akohlsmith/thermador_hpcb36ns_fw/pcb_front.png

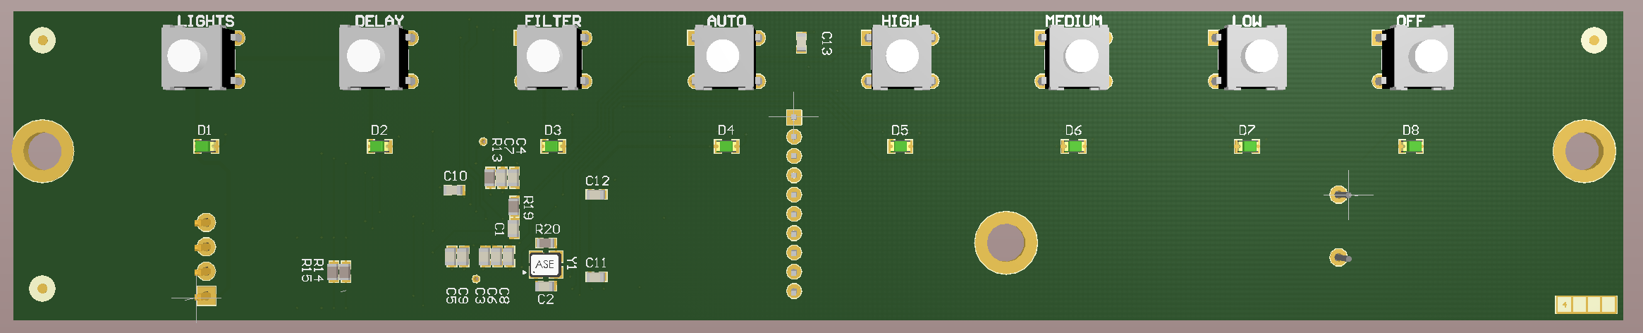
pcb_front.png
