akohlsmith/thermador_hpcb36ns_fw/pcb_back.png

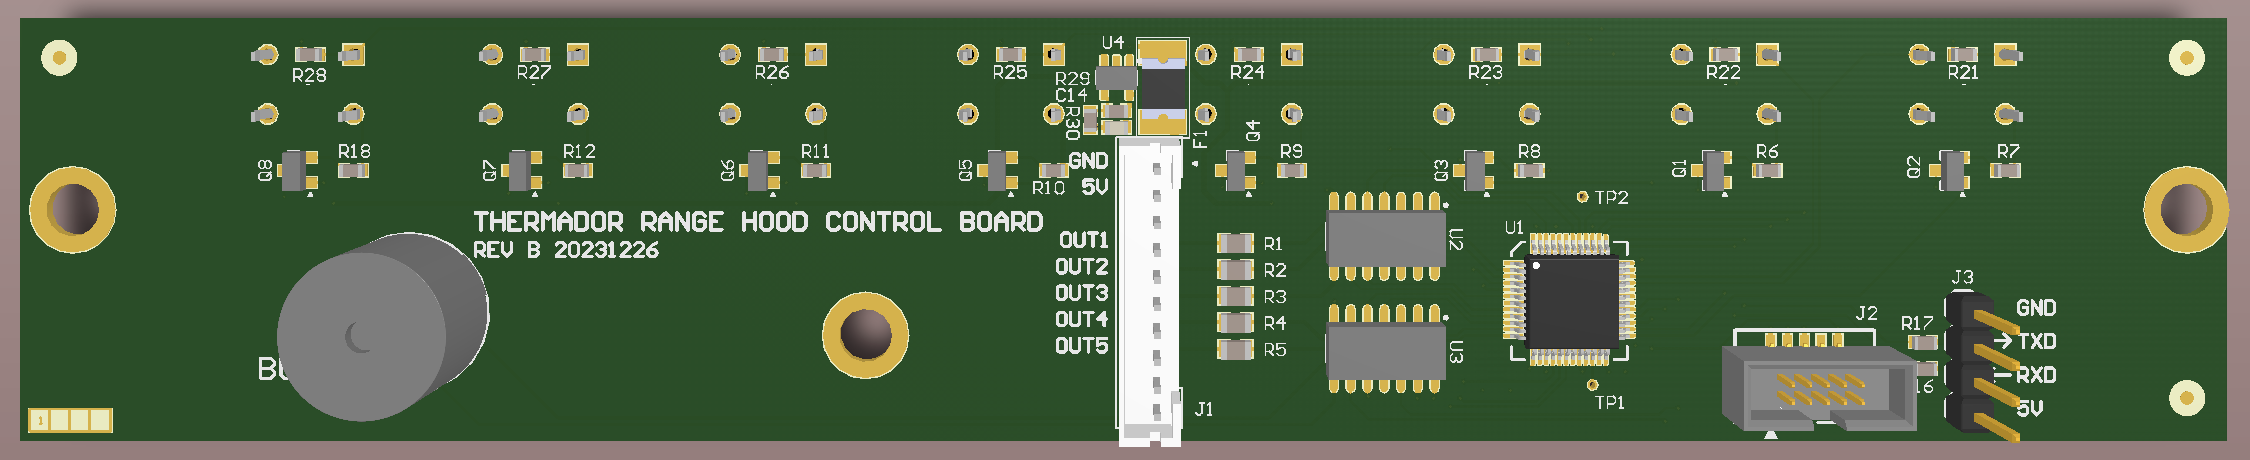
pcb_back.png
