akohlsmith/thermador_hpcb36ns_fw/schematic.pdf

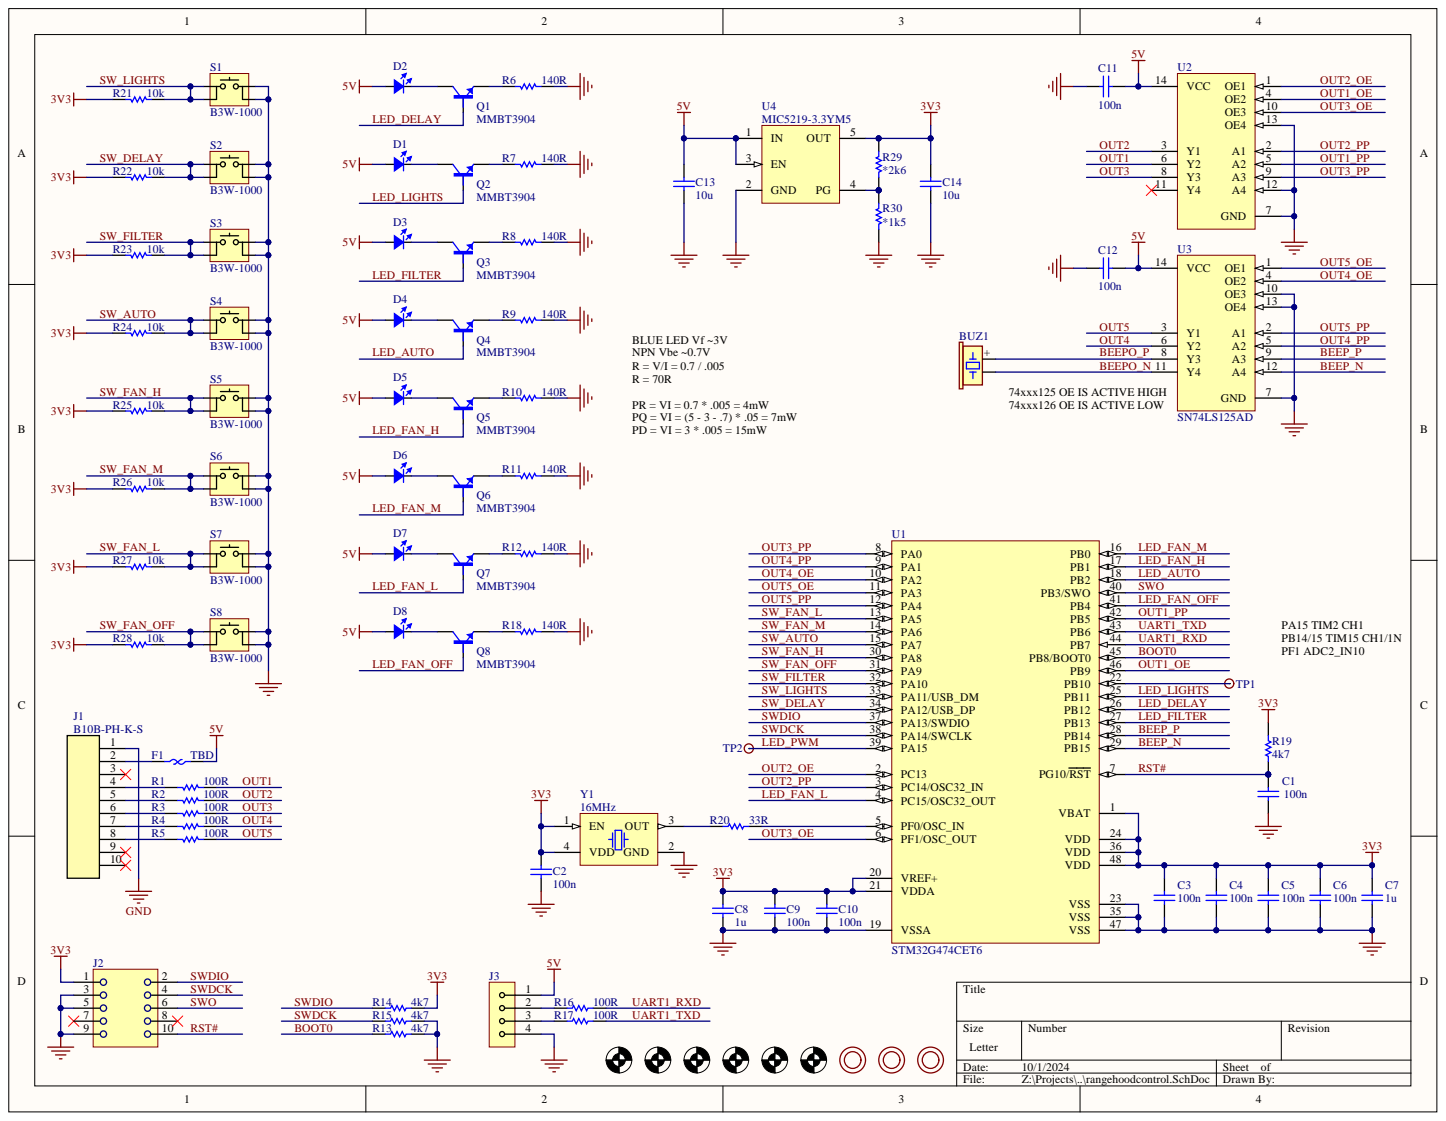
[picture p3: page 1]
