akohlsmith/thermador_hpcb36ns_fw/(commit log)

2023-12-26 I've got LS126s on this board, OE is active-low
2023-12-26 playing with low power mode. Ultimately don't use it because I'm seeing odd issues and no desire to debug them
    [main.c]
2023-12-26 add the output binary - this is what's running on the board in the range hood
2024-10-01 add schematic to the repo
2024-10-01 add front and back pictures of the PCB render
2025-12-27 add a delay on startup to prevent stuttering
    [main.c]
