akohlsmith/thermador_hpcb36ns_fw/(notices)

Notices in the files:
inc/main.h:
Copyright (c) 2023 STMicroelectronics.
All rights reserved.
This software is licensed under terms that can be found in the LICENSE file
